ChanchalSakardeQH/Mandala-String-Art-XY-CNC-plotter/docs/wiring-diagram.png

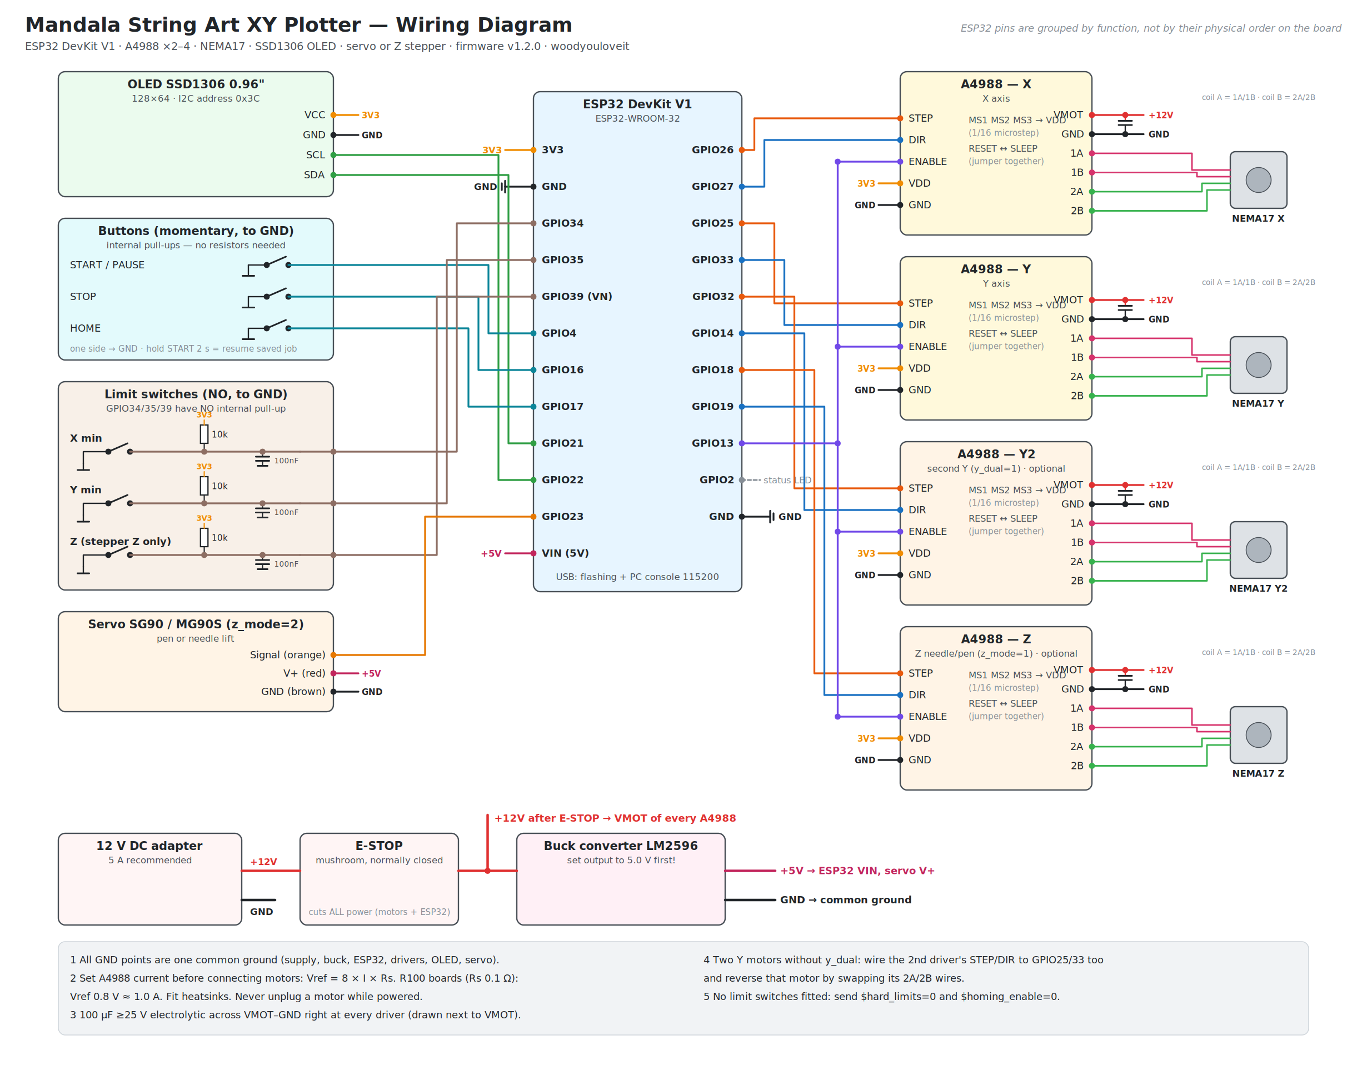
docs/wiring-diagram.png
