ChanchalSakardeQH/Mandala-String-Art-XY-CNC-plotter/web/samples/lotus-template-a4.pdf

Page 1 of 4 (row 1, column 1) | Lotus - print at 100% (Actual size)

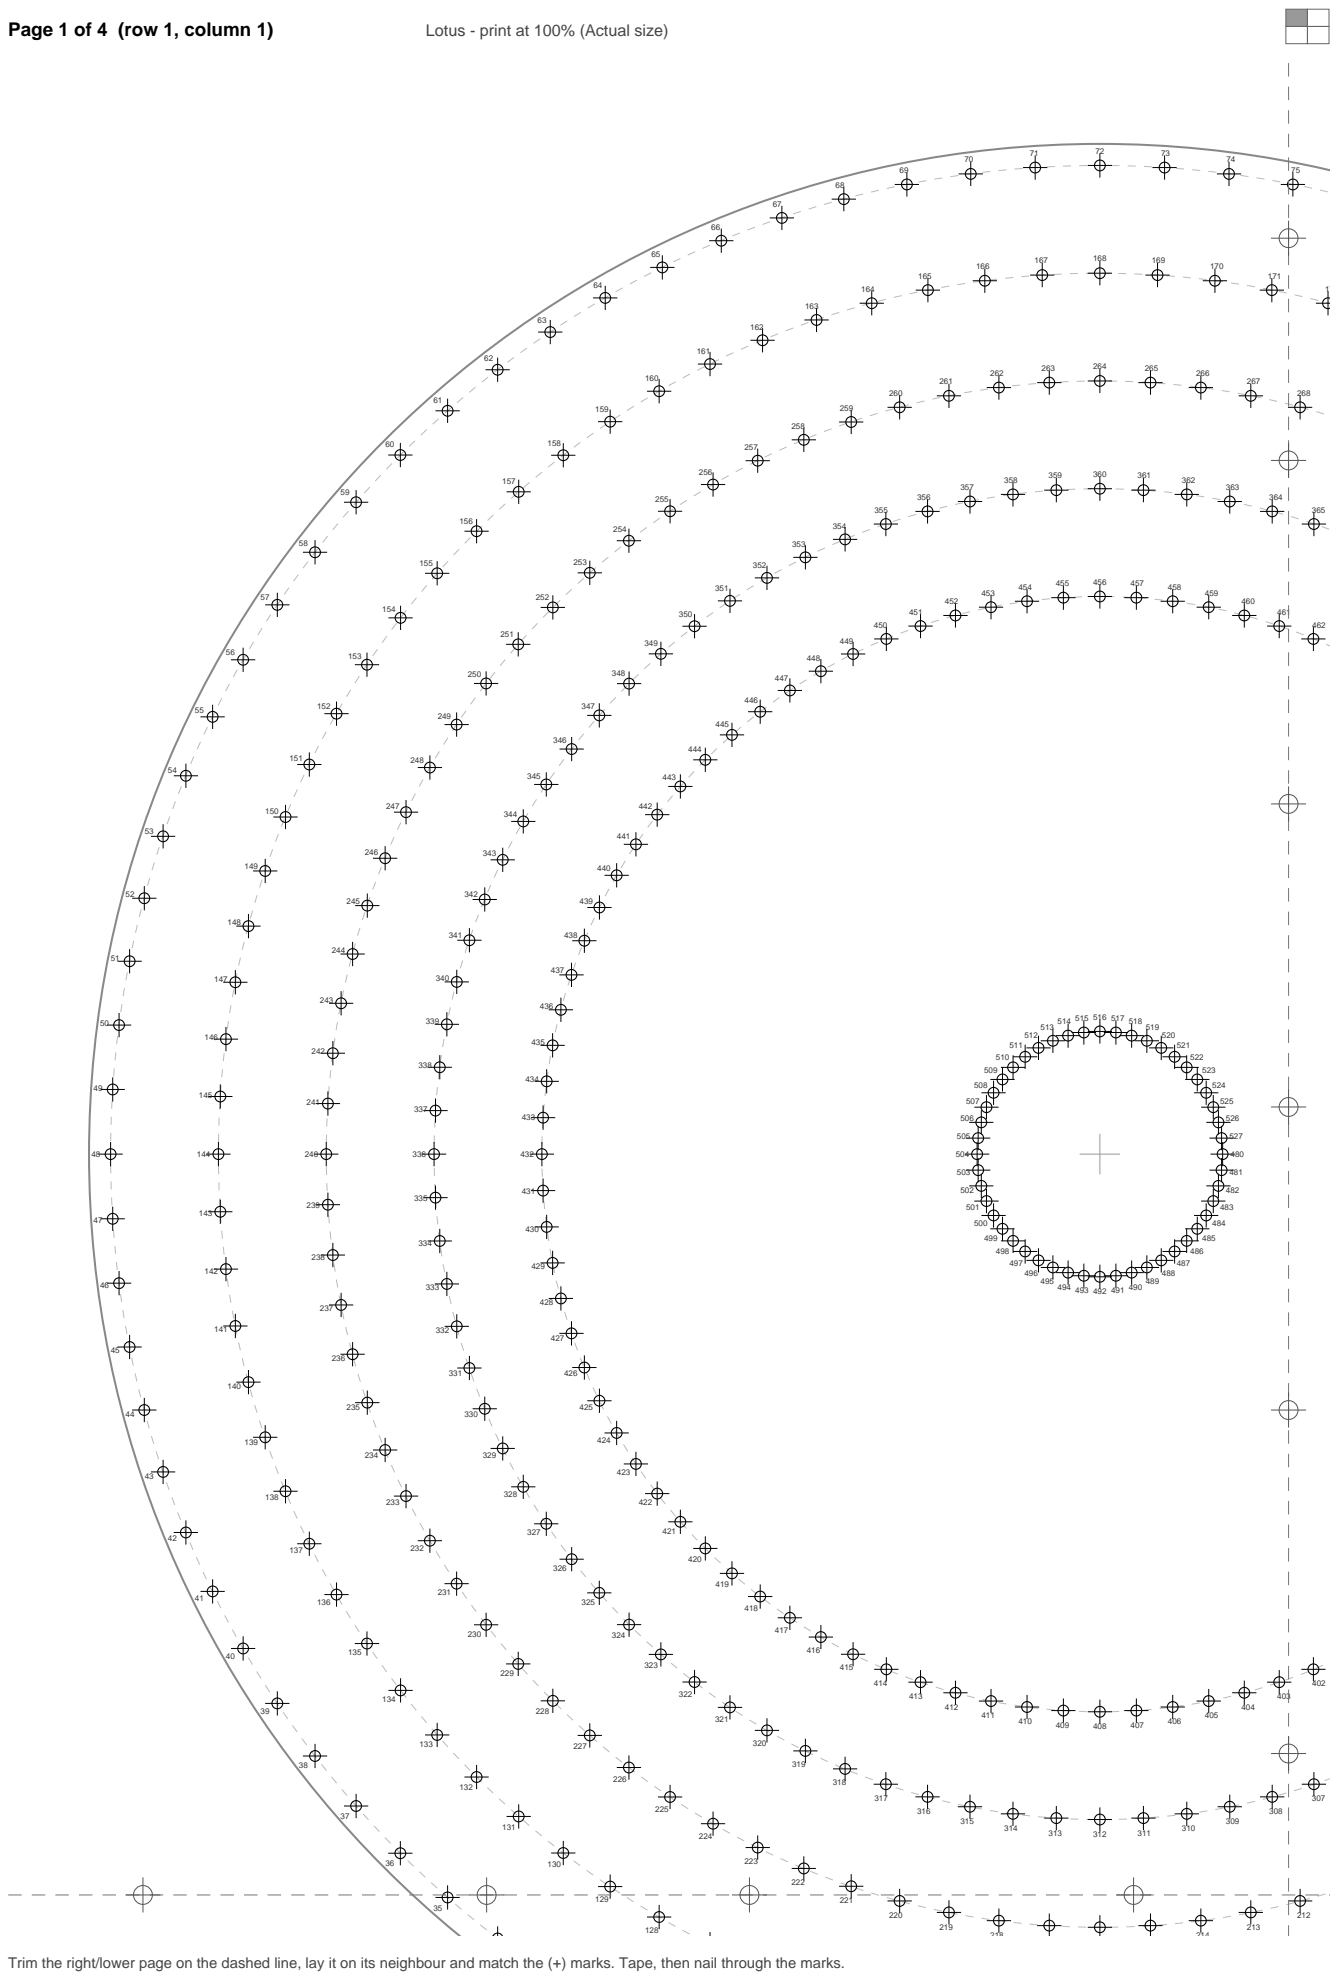
[picture p2: page 1]

Trim the right/lower page on the dashed line, lay it on its neighbour and match the (+) marks. Tape, then nail through the marks.

Page 2 of 4 (row 1, column 2) | Lotus - print at 100% (Actual size)

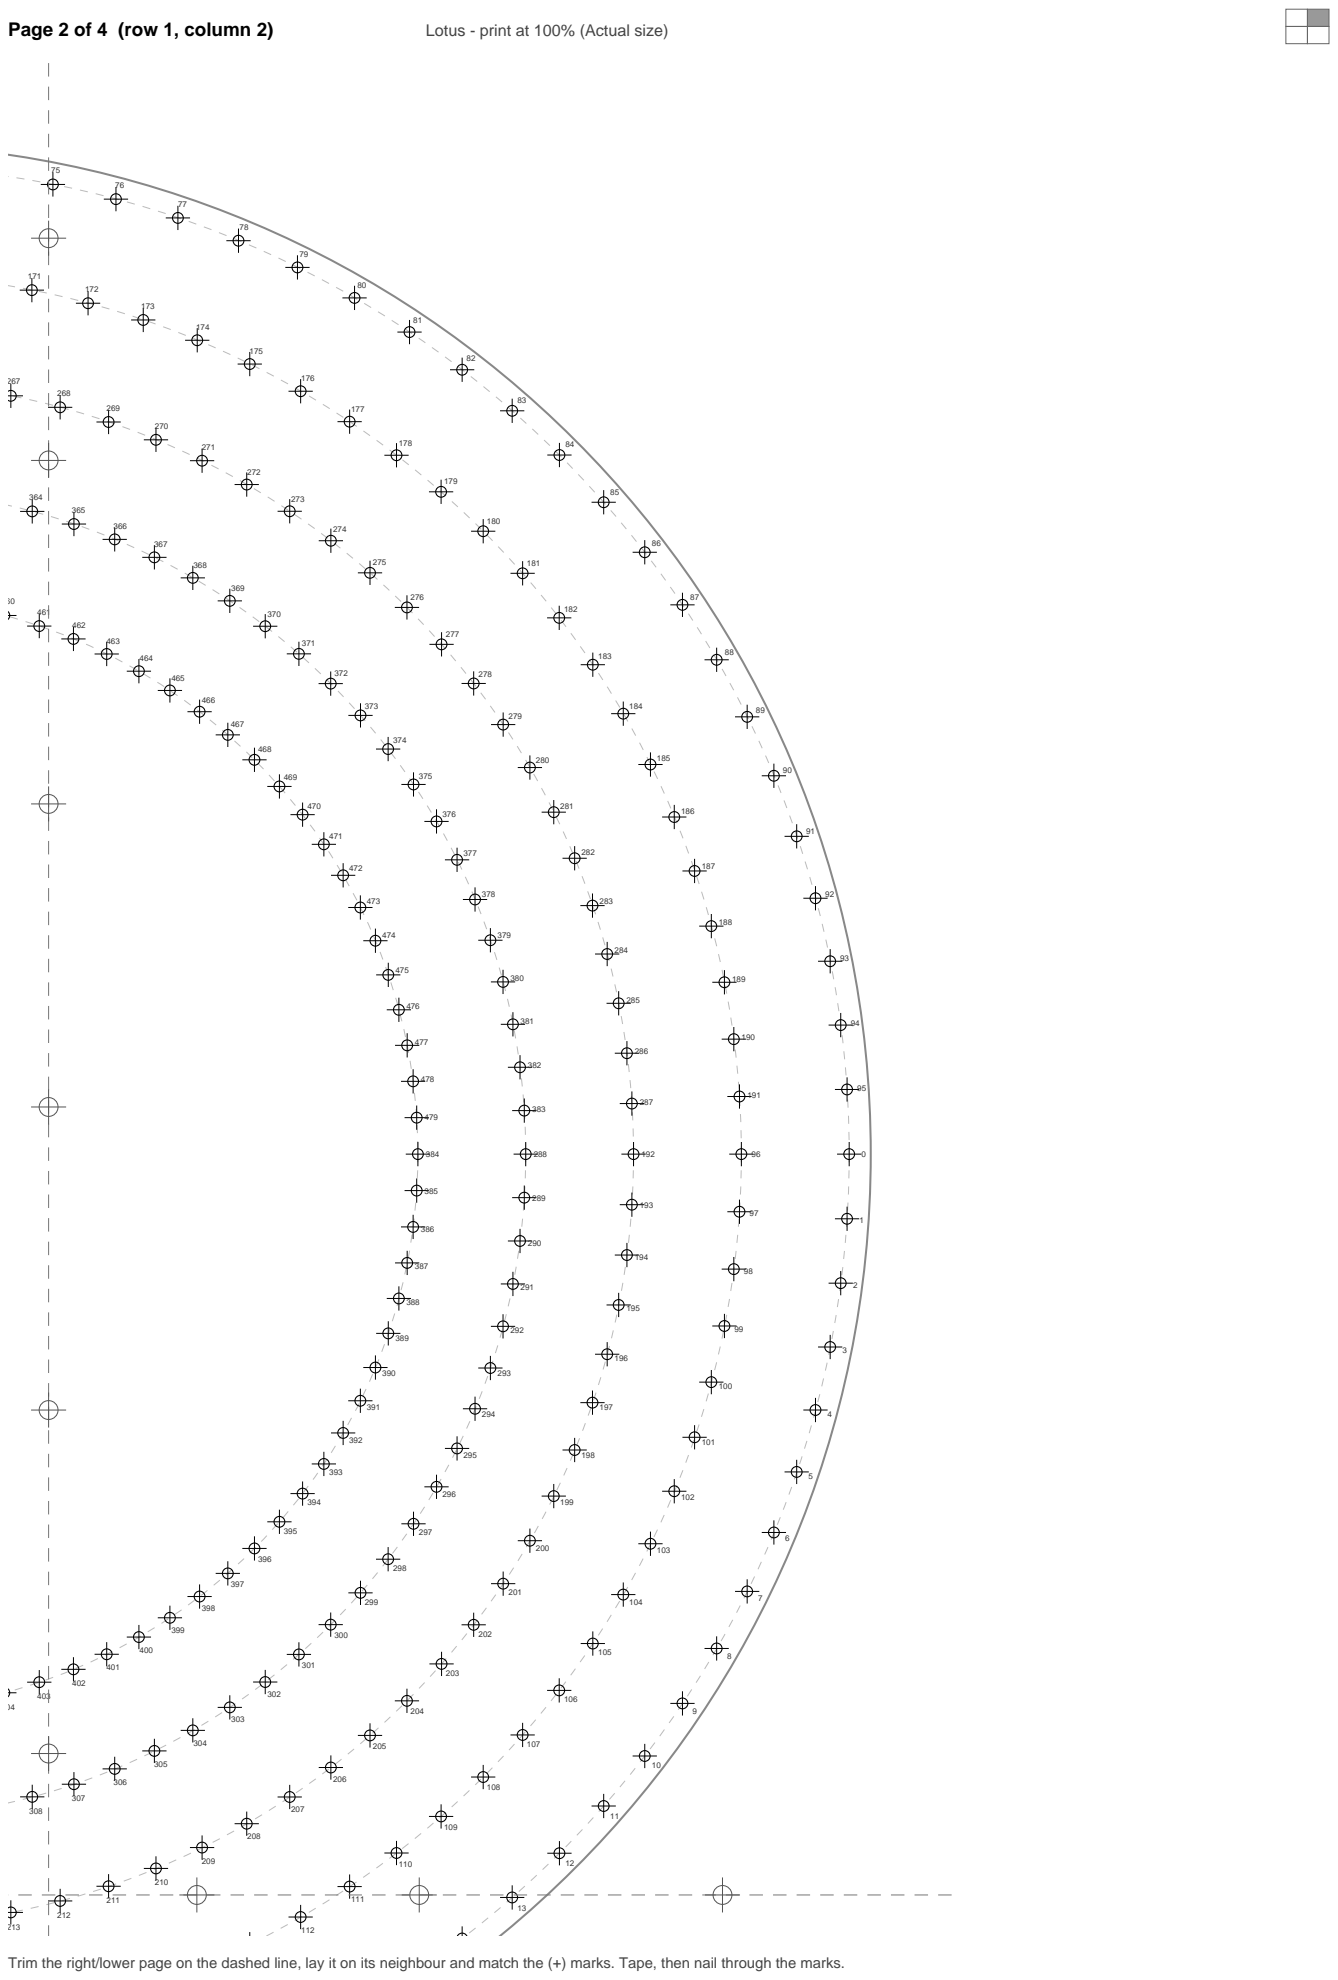
[picture p3: page 2]

# Lotus - nail template

Page 3 of 4 (row 2, column 1) | Lotus - print at 100% (Actual size)

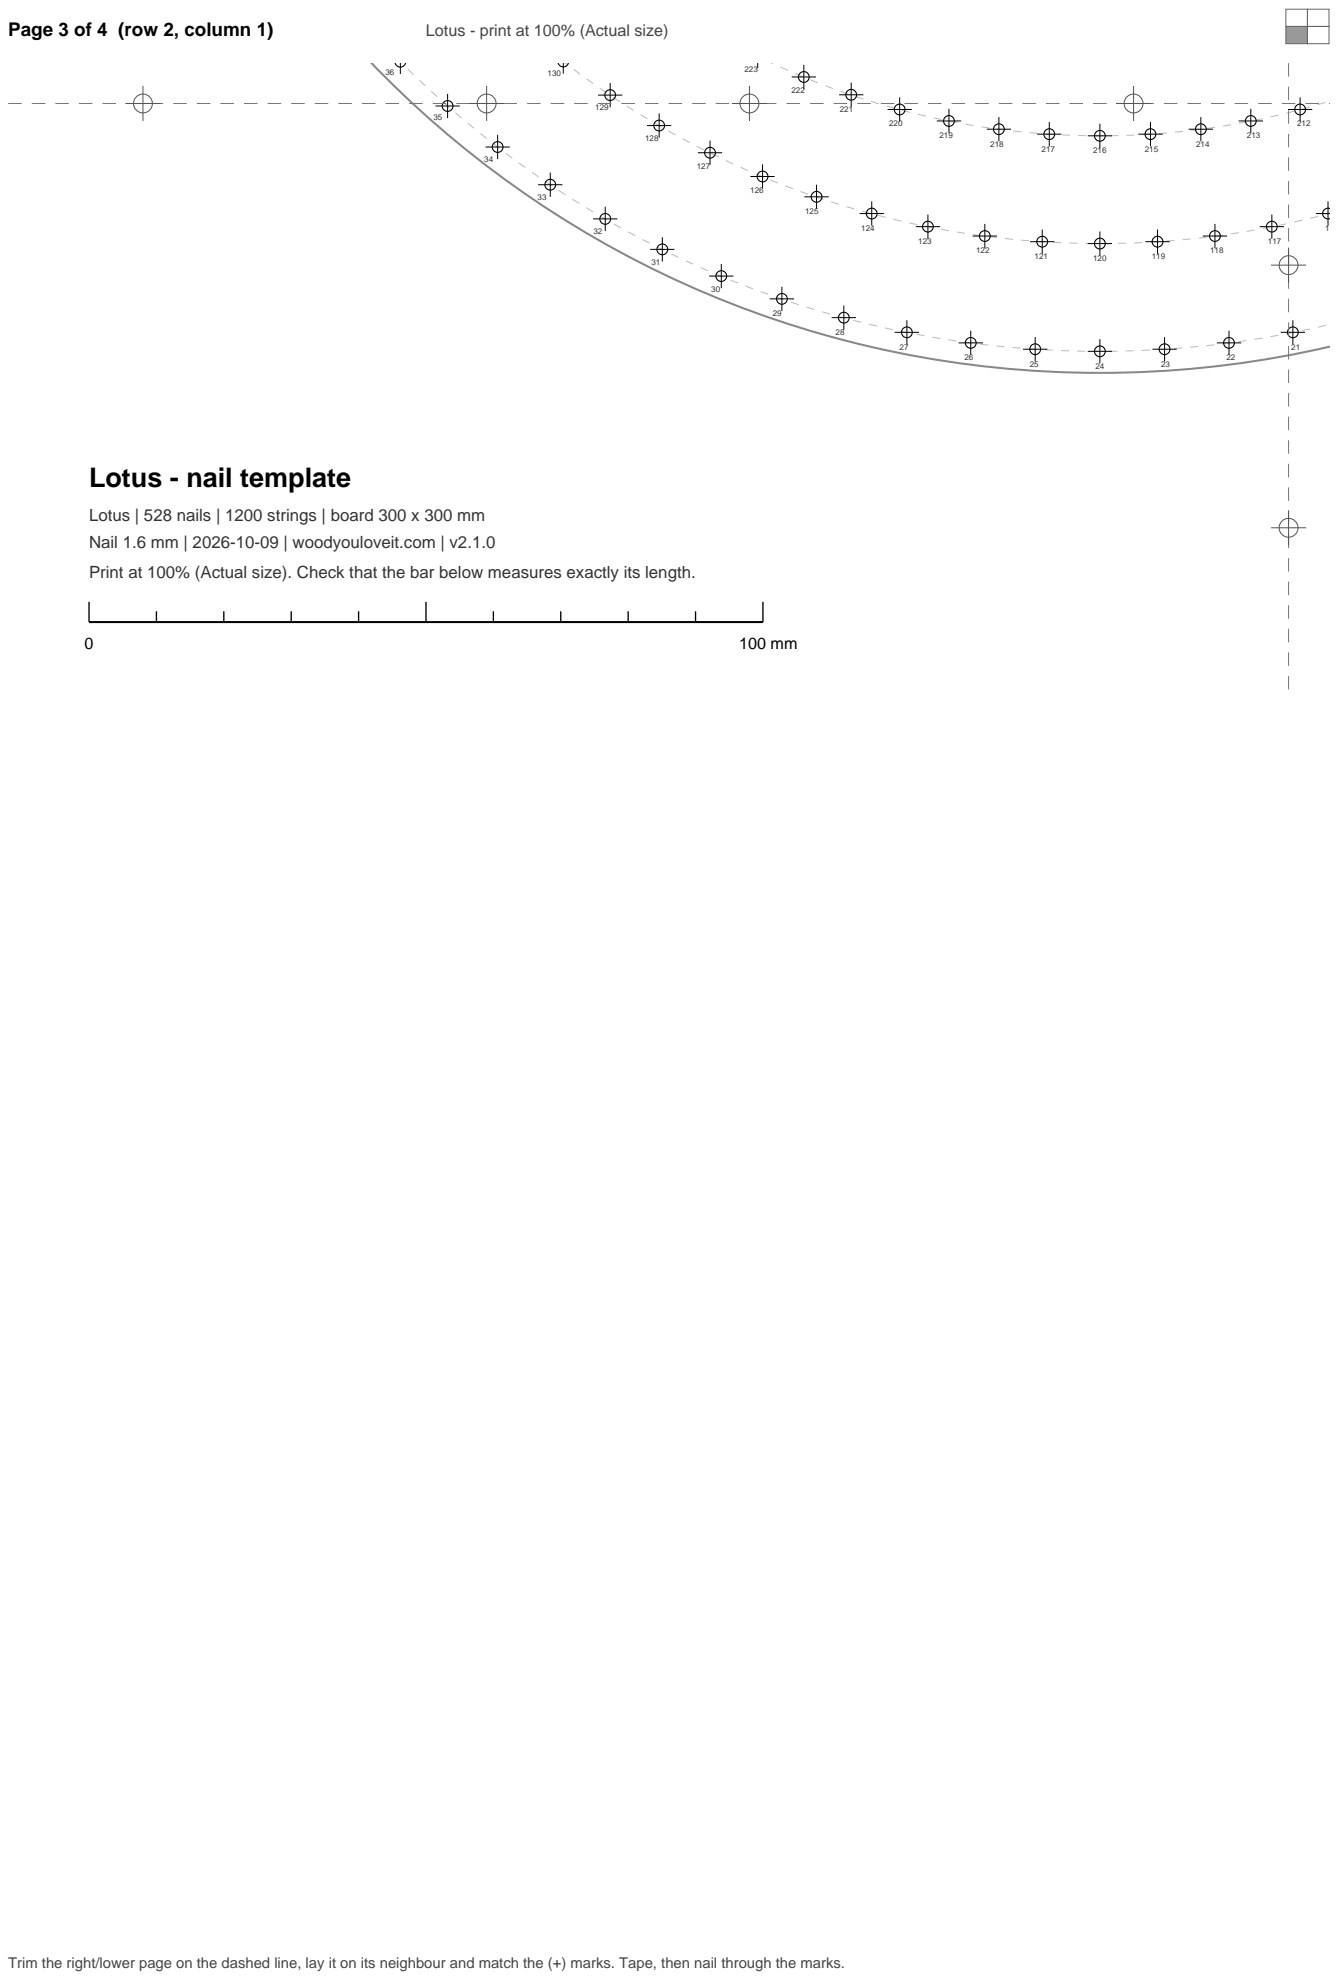
[picture p4: page 3]

Lotus | 528 nails | 1200 strings | board 300 x 300 mm
Nail 1.6 mm | 2026-10-09 | woodyouloveit.com | v2.1.0
Print at 100% (Actual size). Check that the bar below measures exactly its length.

Page 4 of 4 (row 2, column 2) | Lotus - print at 100% (Actual size)

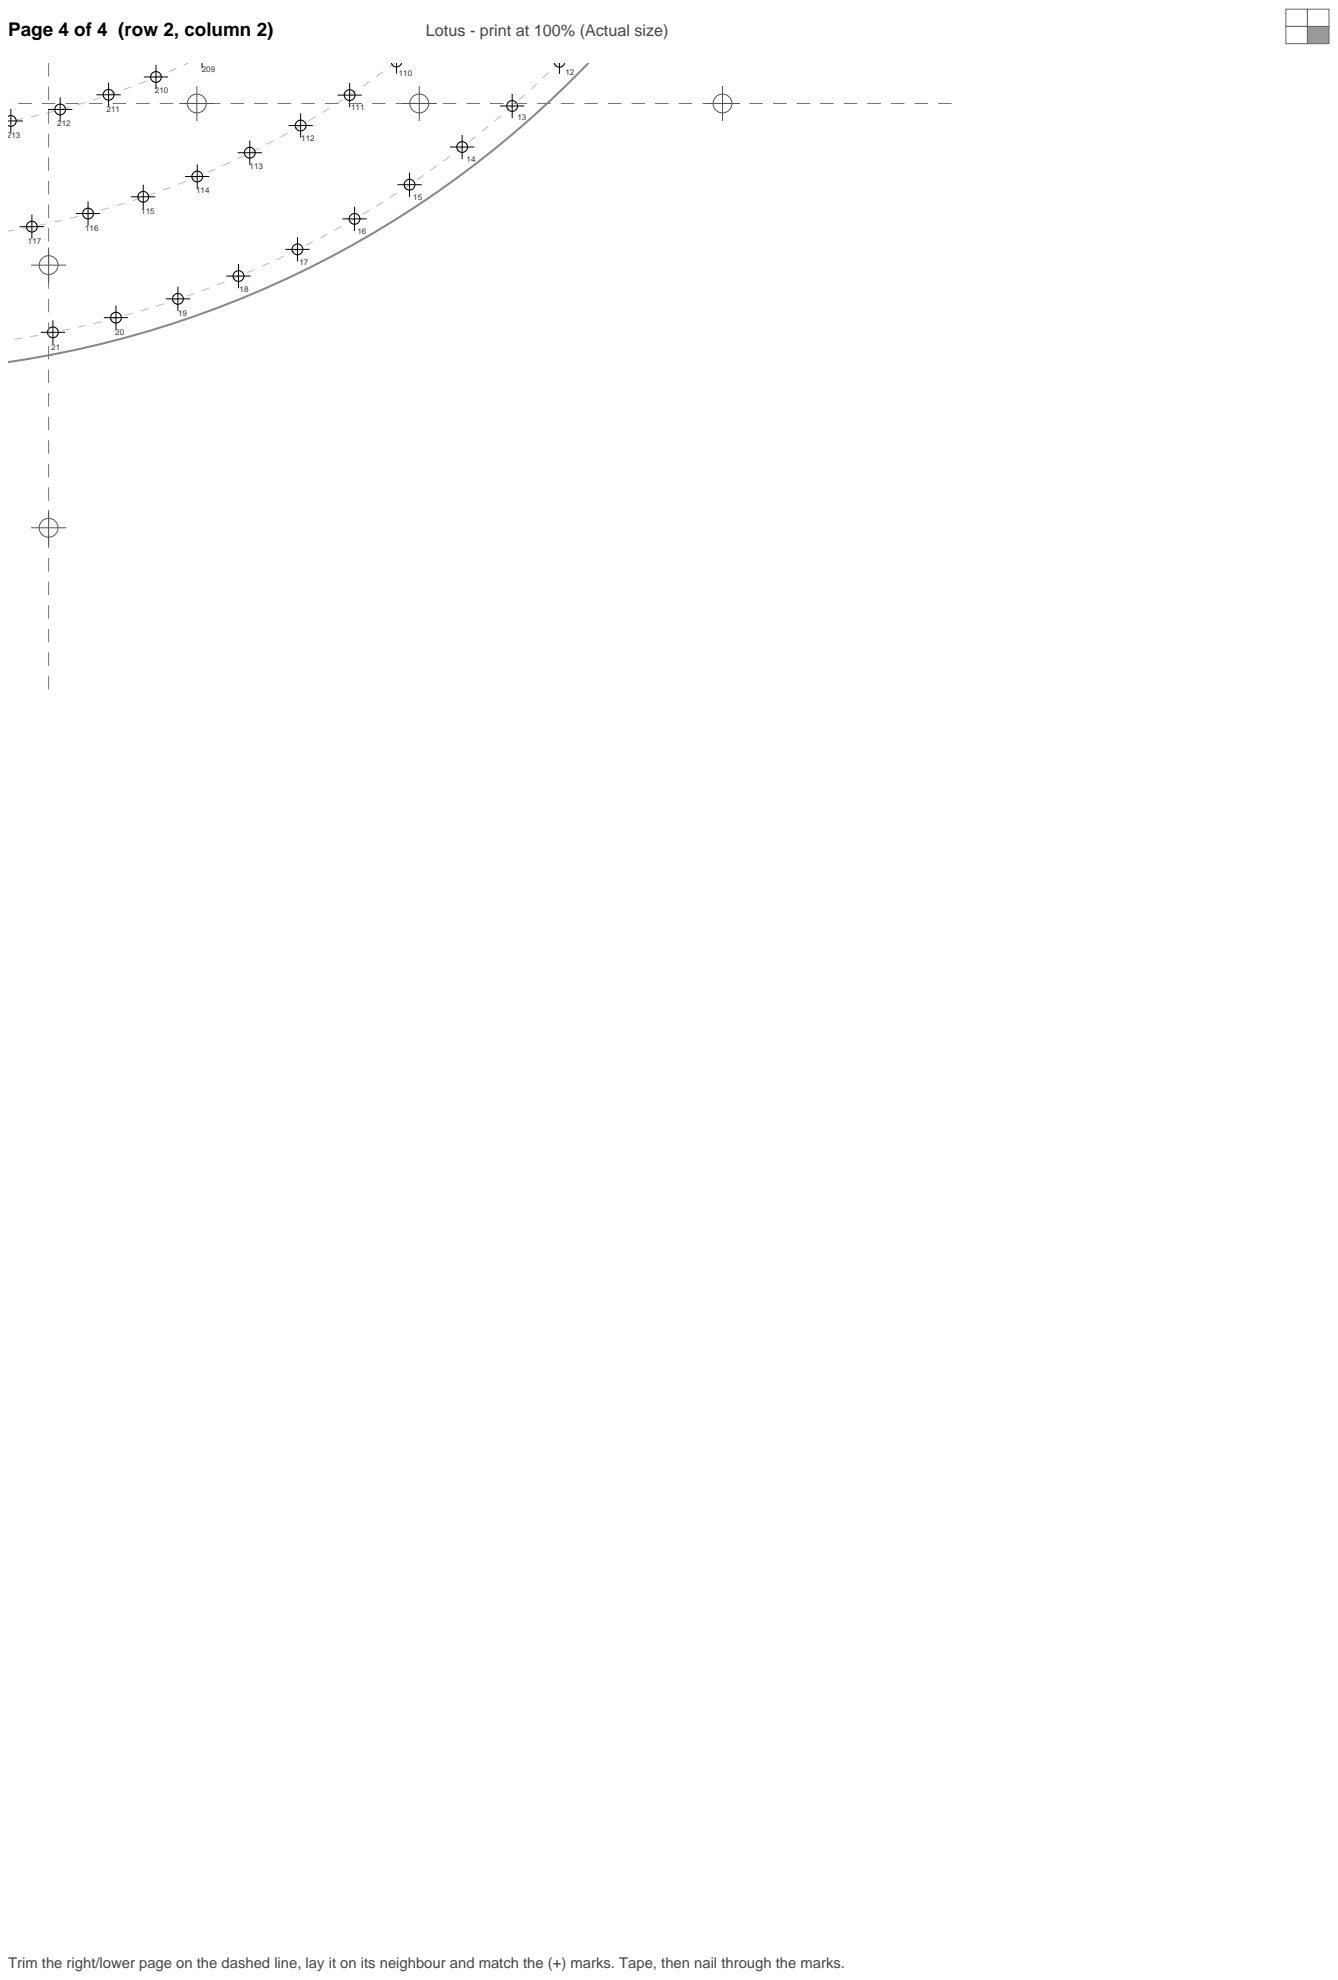
[picture p5: page 4]
