ChanchalSakardeQH/Mandala-String-Art-XY-CNC-plotter/(commit log)

2026-10-14 initial Base Arduino and Android App
2026-10-17 fixed operation for Pause Resume
    [Config.h, Motion.cpp]
